Cherohan/Base-ESP32S3-Simple-FOC-Verification-Board/hardware/version2/2.1/SCH_Schematic1_2_2026-10-08.pdf

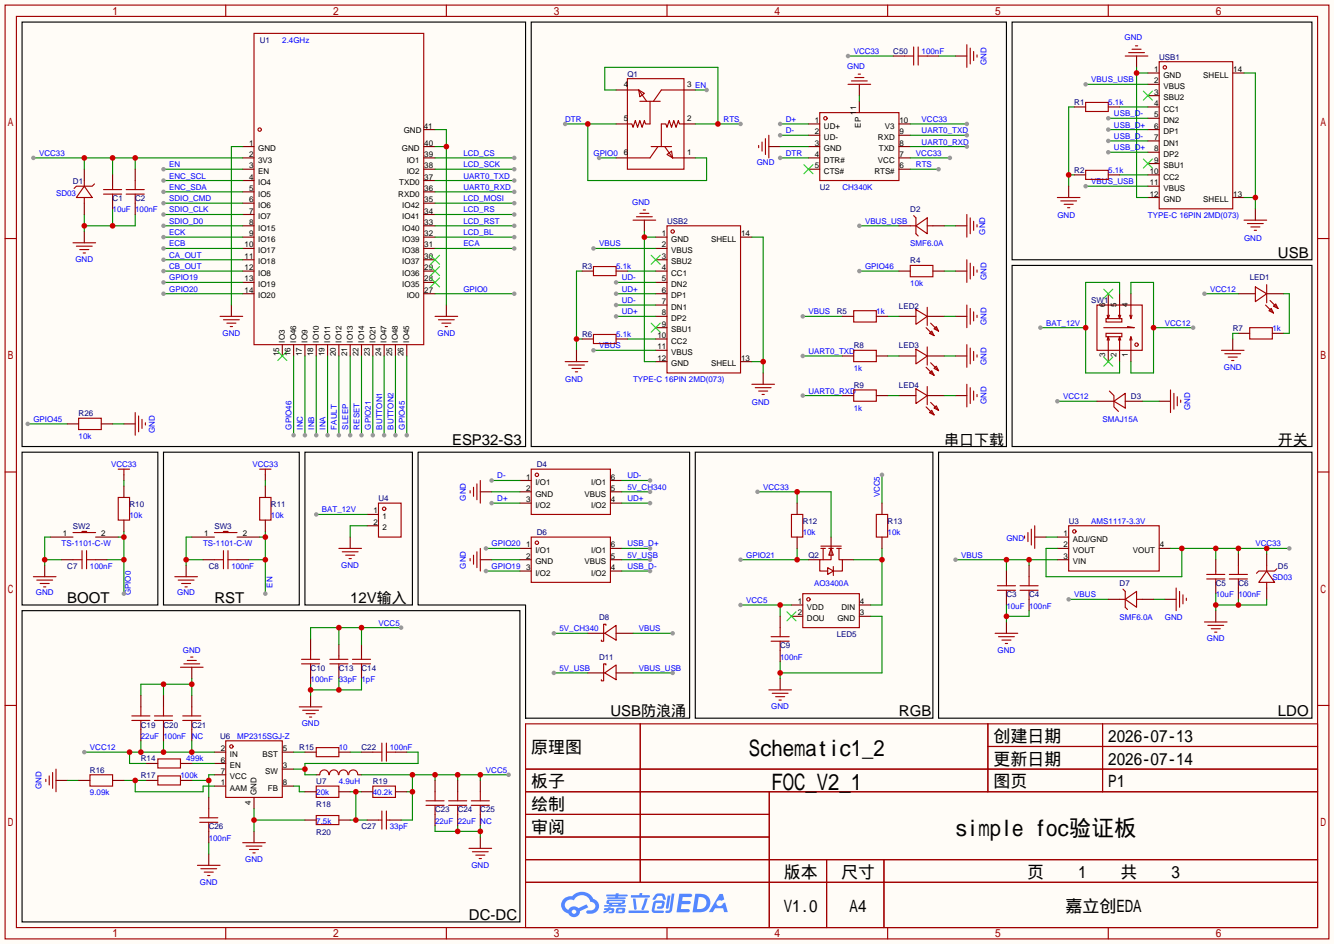
[picture p15: page 1]

原理图 | Schematic1_2 | 创建日期 | 2026-07-13
板子 | FOC_V2_1 | 图页 | P1
绘制 | | simple foc验证板
审阅

更新日期 | 2026-07-14

V1.0 | A4 | 嘉立创EDA

## 电流采样

AS5600

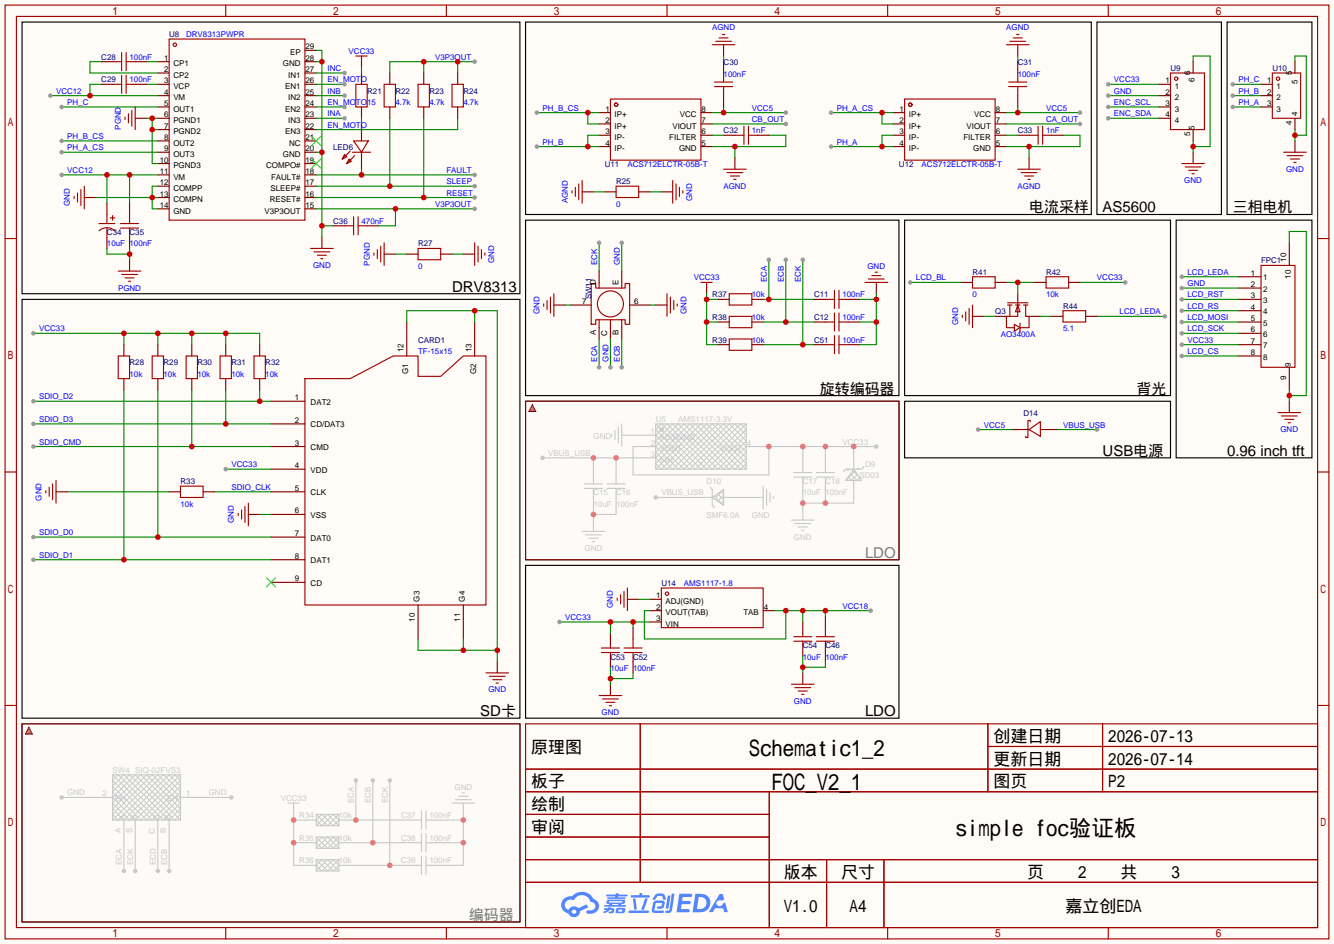
[picture p16: page 2]

原理图 | Schematic1_2 | 创建日期 | 2026-07-13
板子 | FOC_V2_1 | 图页 | P2
绘制 | | simple foc验证板
审阅

更新日期 | 2026-07-14

# 单颗LED正向压降2.1V

## 额定电流20mA

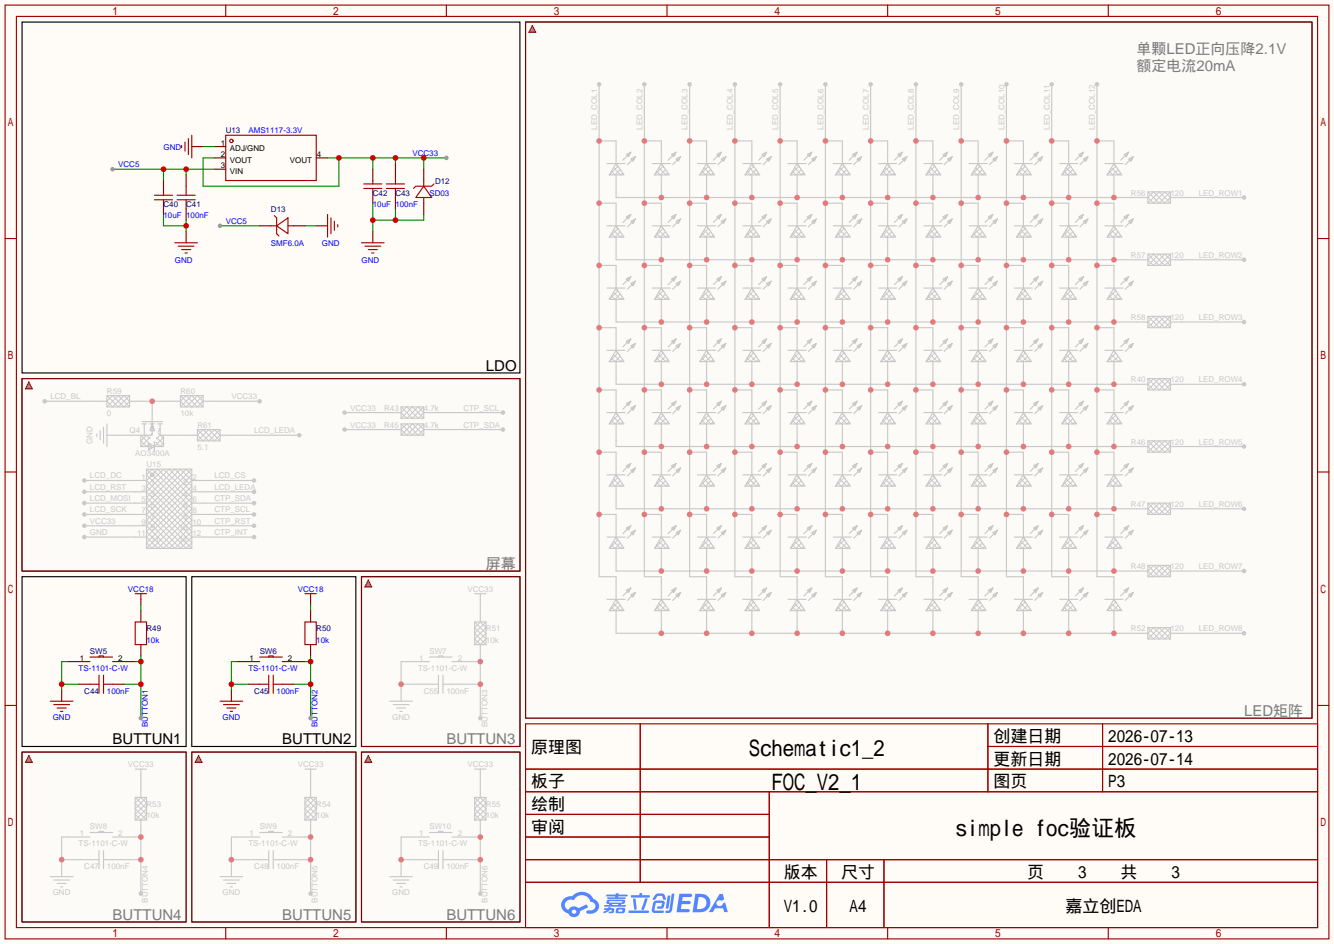
[picture p17: page 3]

原理图 | Schematic1_2 | 创建日期 | 2026-07-13
板子 | FOC_V2_1 | 图页 | P3
绘制 | | simple foc验证板
审阅

更新日期 | 2026-07-14
