Cherohan/Base-ESP32S3-Simple-FOC-Verification-Board/hardware/version2/2.2/SCH_Schematic1_1_2026-10-08.pdf

# Attention

## 当前版本存在以下问题：

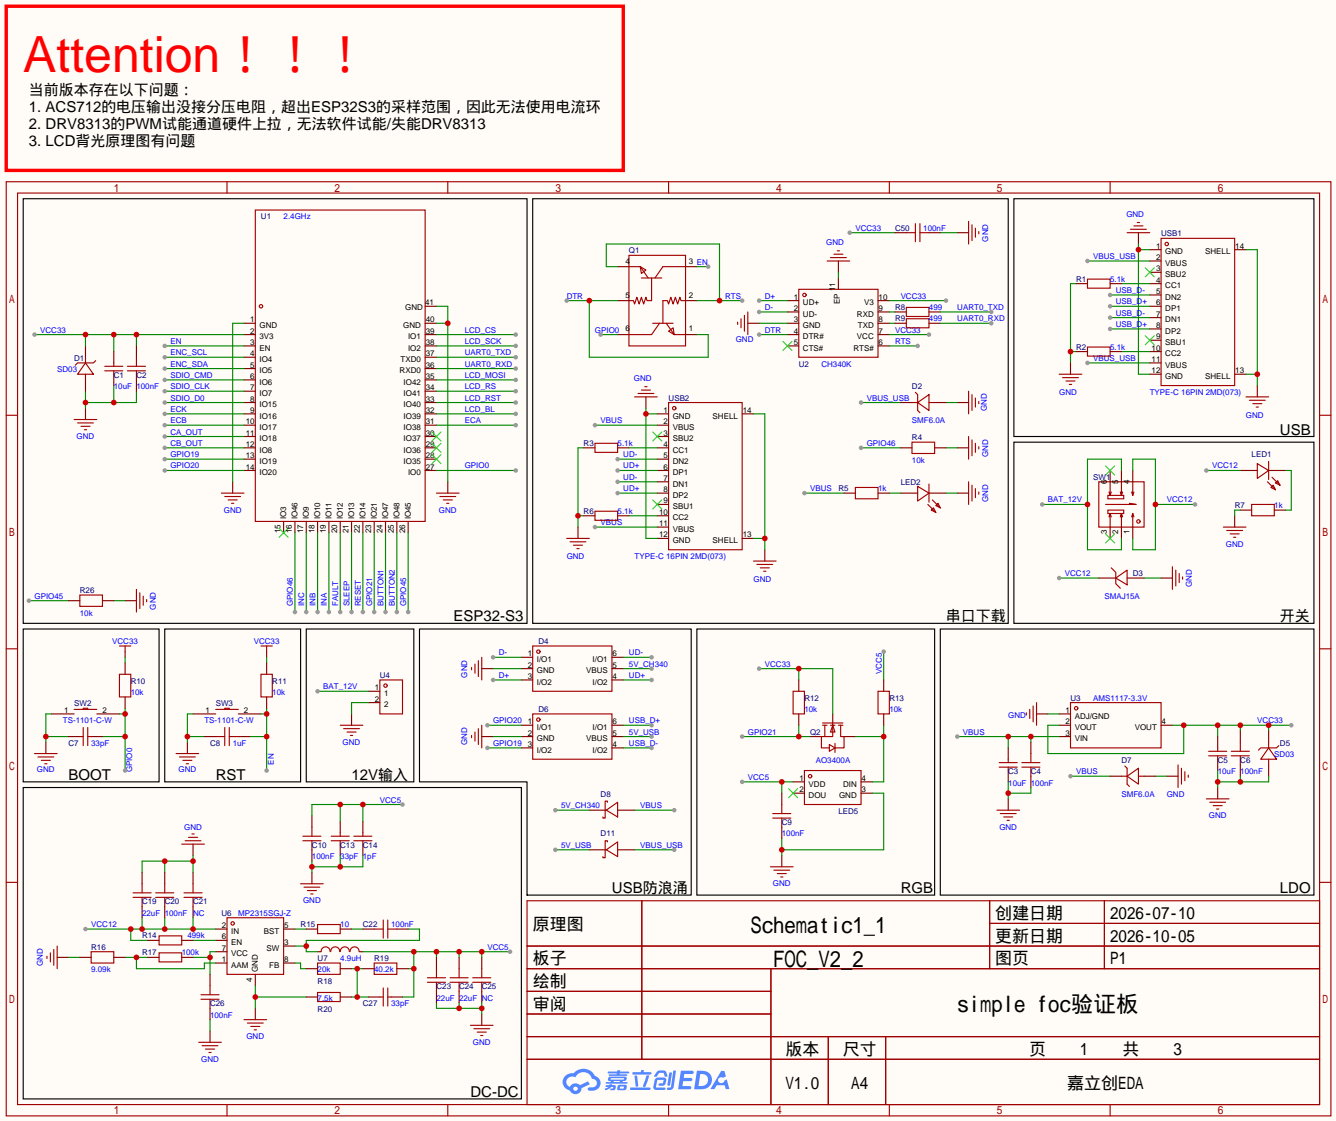
[picture p18: page 1]

原理图 | Schematic1_1 | 创建日期 | 2026-07-10
板子 | FOC_V2_2 | 图页 | P1
绘制 | | simple foc验证板
审阅

更新日期 | 2026-10-05

V1.0 | A4 | 嘉立创EDA

## 电流采样

AS5600

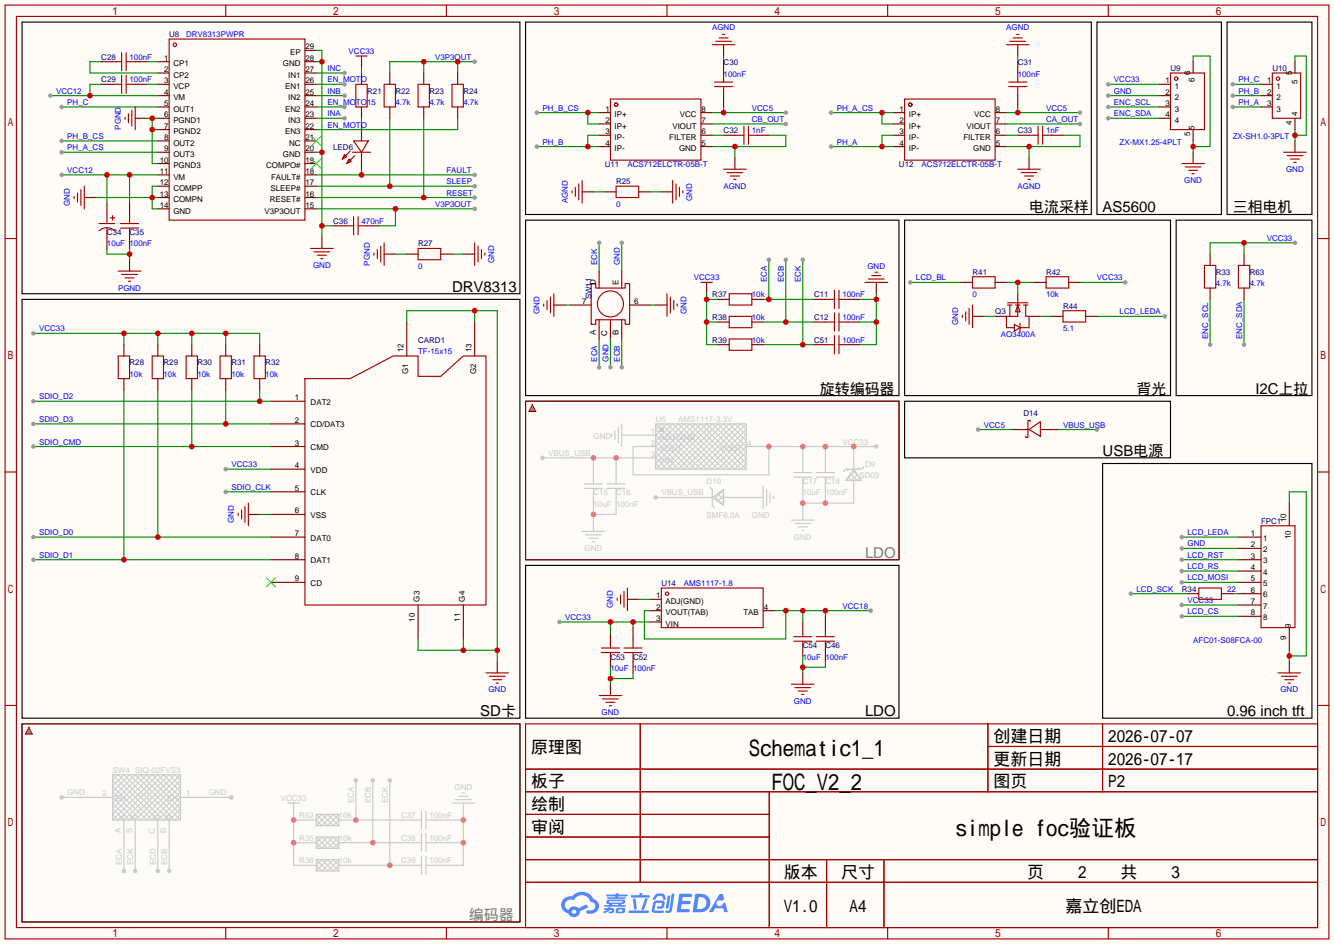
[picture p19: page 2]

原理图 | Schematic1_1 | 创建日期 | 2026-07-07
板子 | FOC_V2_2 | 图页 | P2
绘制 | | simple foc验证板
审阅

更新日期 | 2026-07-17

# 单颗LED正向压降2.1V

## 额定电流20mA

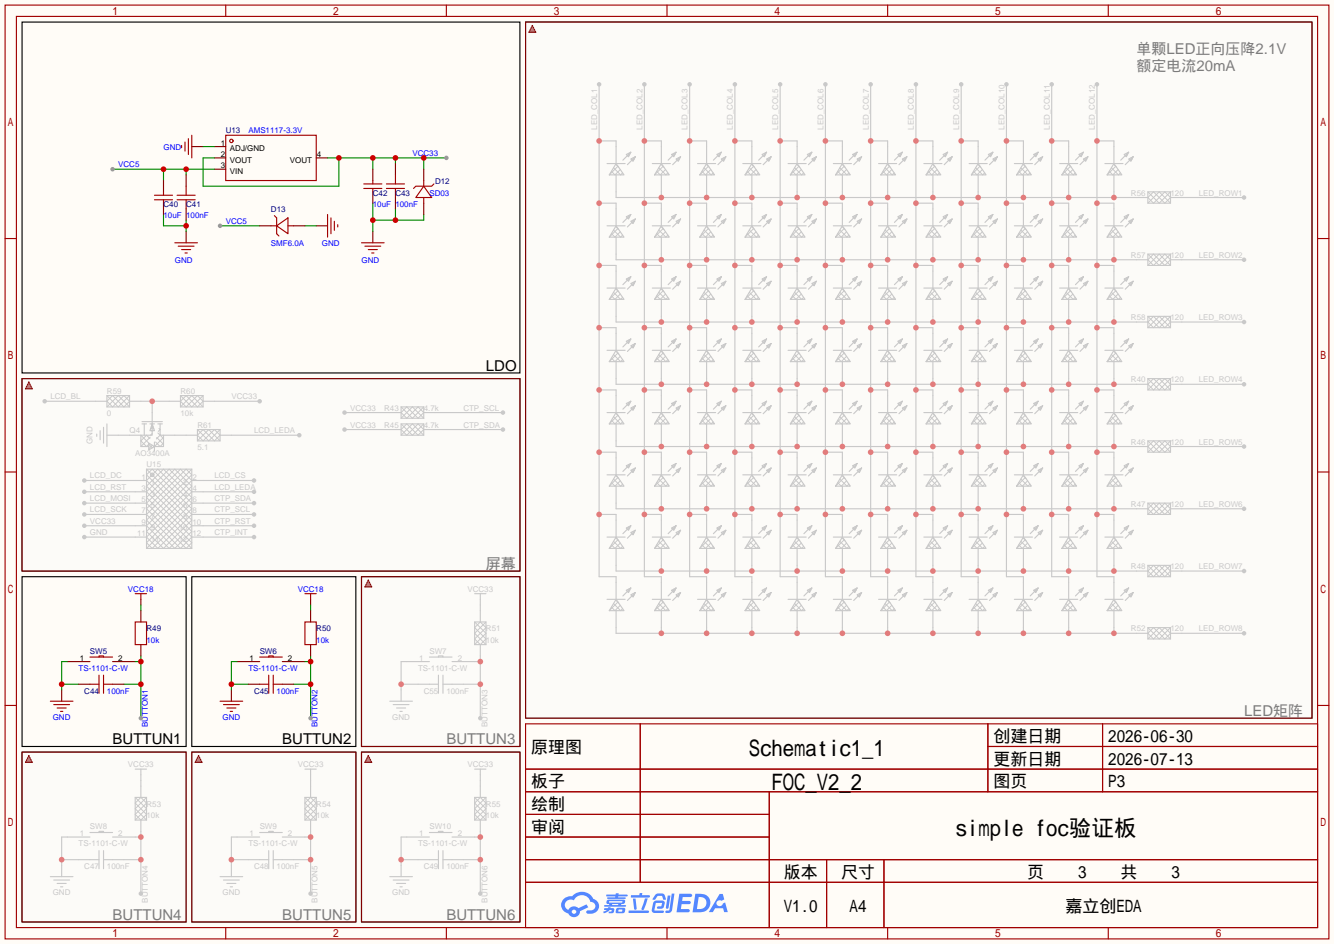
[picture p20: page 3]

原理图 | Schematic1_1 | 创建日期 | 2026-06-30
板子 | FOC_V2_2 | 图页 | P3
绘制 | | simple foc验证板
审阅

更新日期 | 2026-07-13
