Cherohan/Base-ESP32S3-Simple-FOC-Verification-Board/hardware/version2/2.3/SCH_Schematic1_3_2026-10-08.pdf

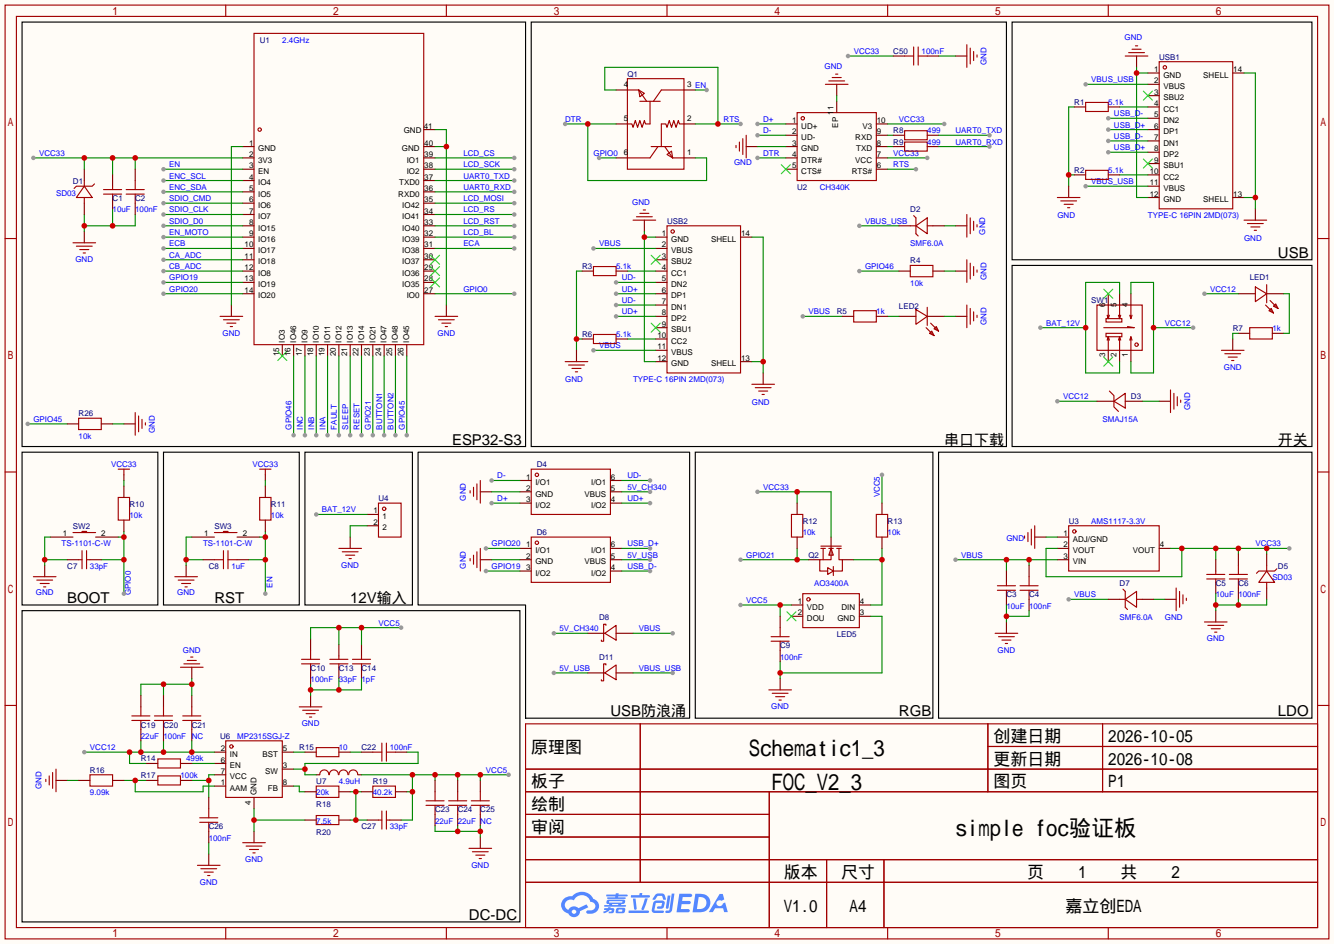
[picture p21: page 1]

原理图 | Schematic1_3 | 创建日期 | 2026-10-05
板子 | FOC_V2_3 | 图页 | P1
绘制 | | simple foc验证板
审阅

更新日期 | 2026-10-08

V1.0 | A4 | 嘉立创EDA

## 电流采样

AS5600 | 三相电机

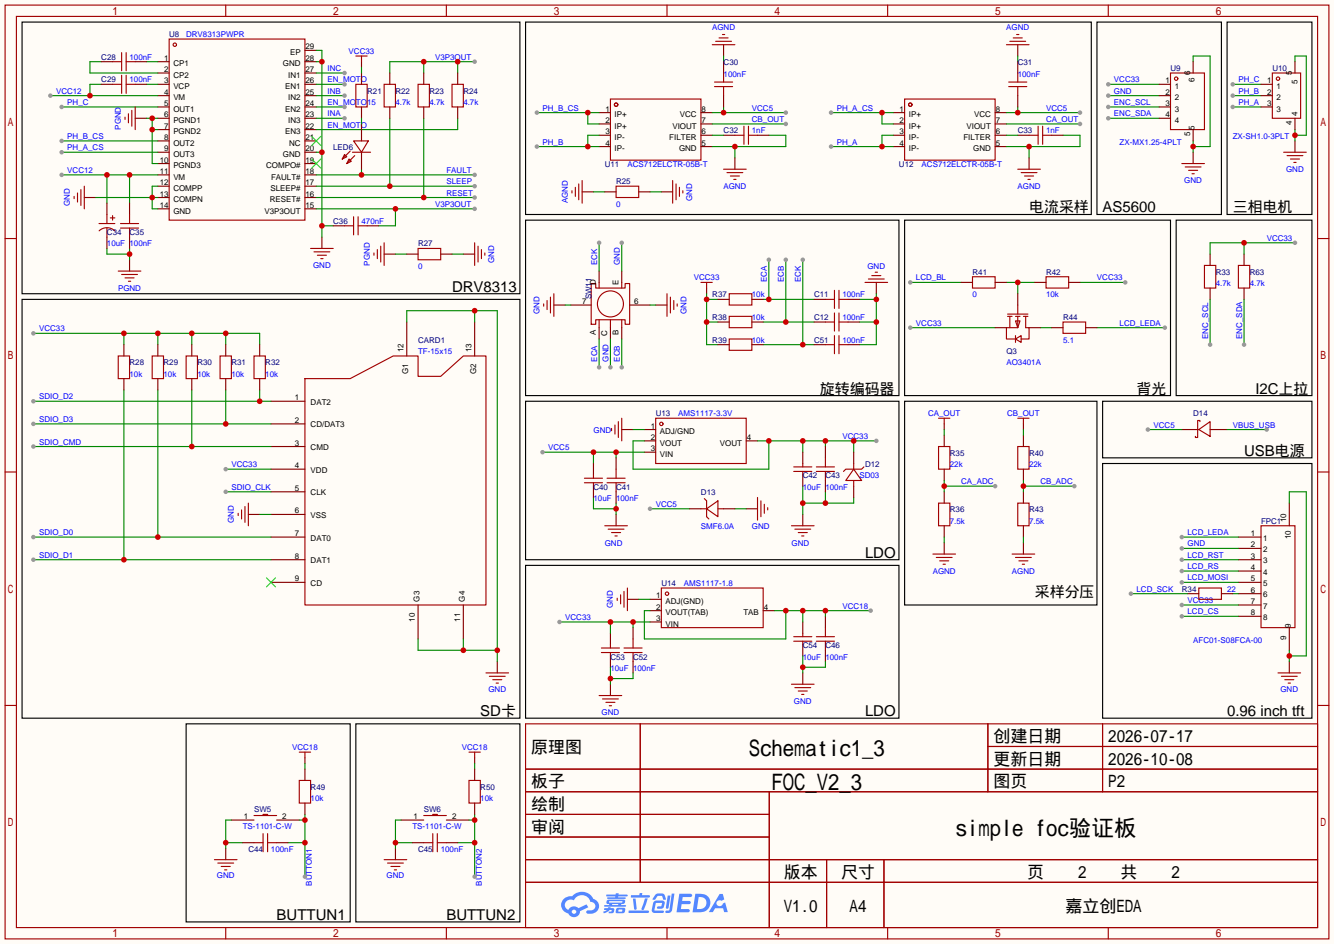
[picture p22: page 2]

原理图 | Schematic1_3 | 创建日期 | 2026-07-17
板子 | FOC_V2_3 | 图页 | P2

更新日期 | 2026-10-08

V1.0 | A4 | 嘉立创EDA
