Cherohan/Base-ESP32S3-Simple-FOC-Verification-Board/hardware/version2/2.1/PCB_FOC_V2_1_2_2026-10-08.pdf

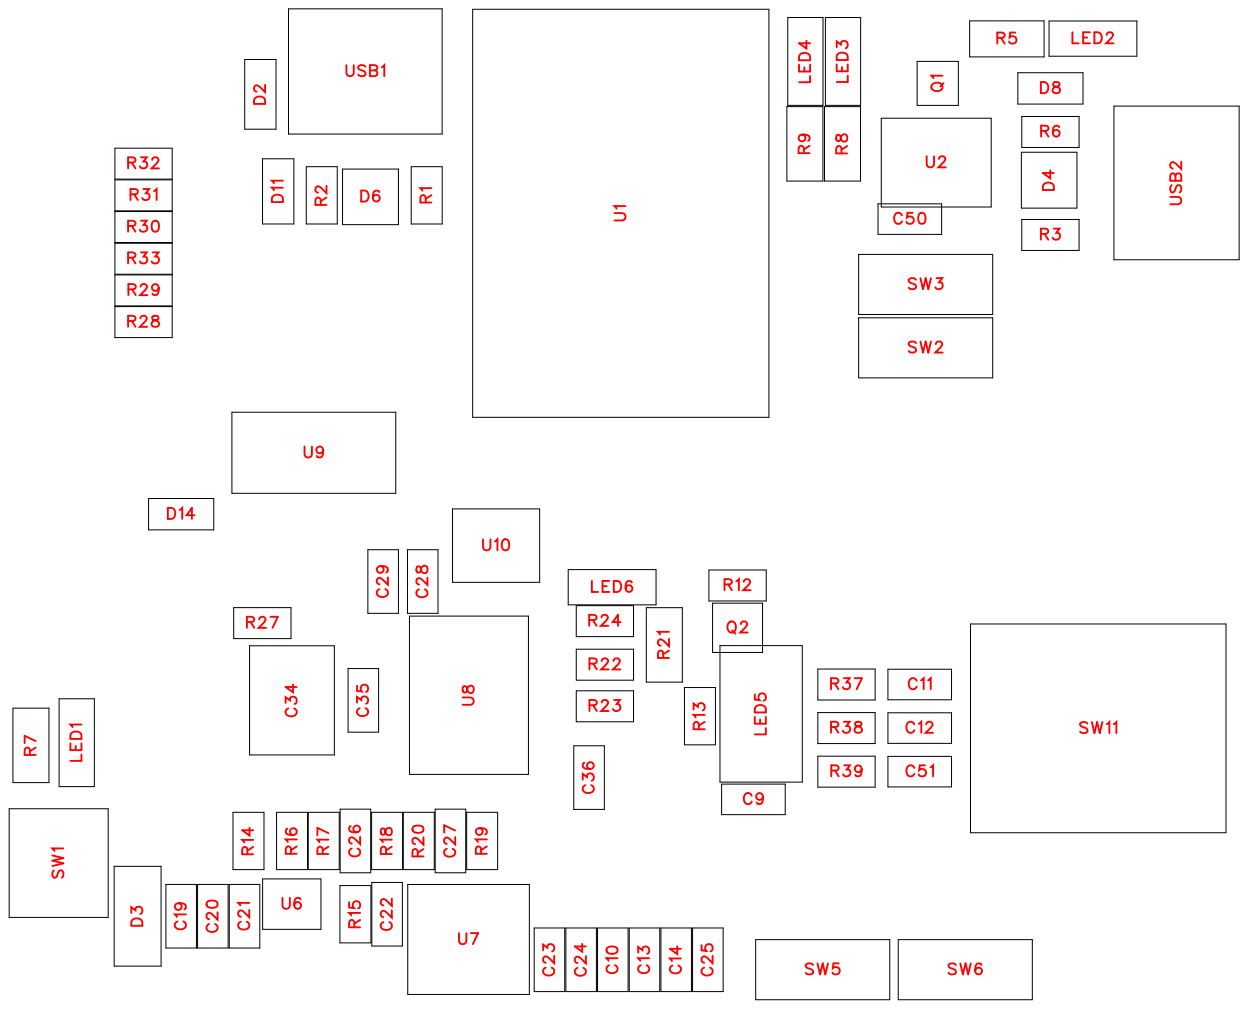
[picture p23: page 1]

R37 | C11
R38 | C12
R39 | C51

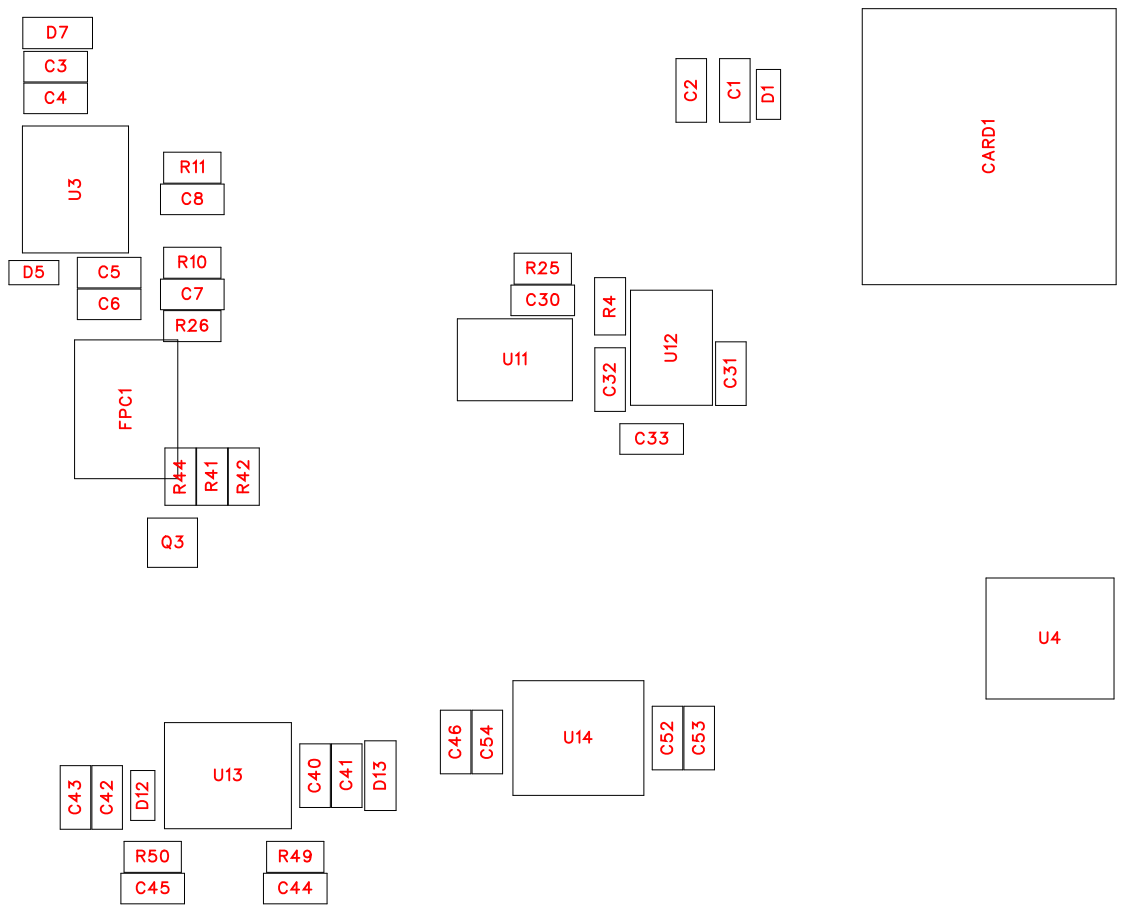
[picture p24: page 2]

R50 | R49
C45 | C44

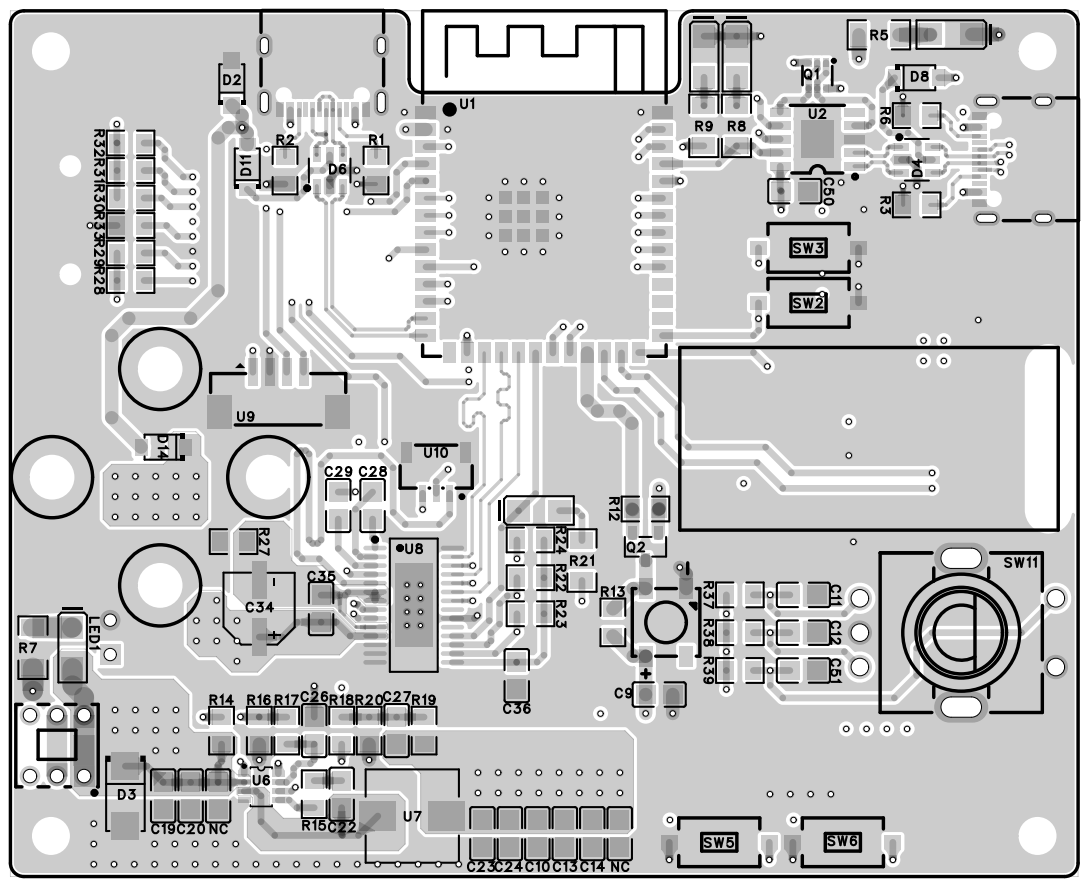
[picture p25: page 3]

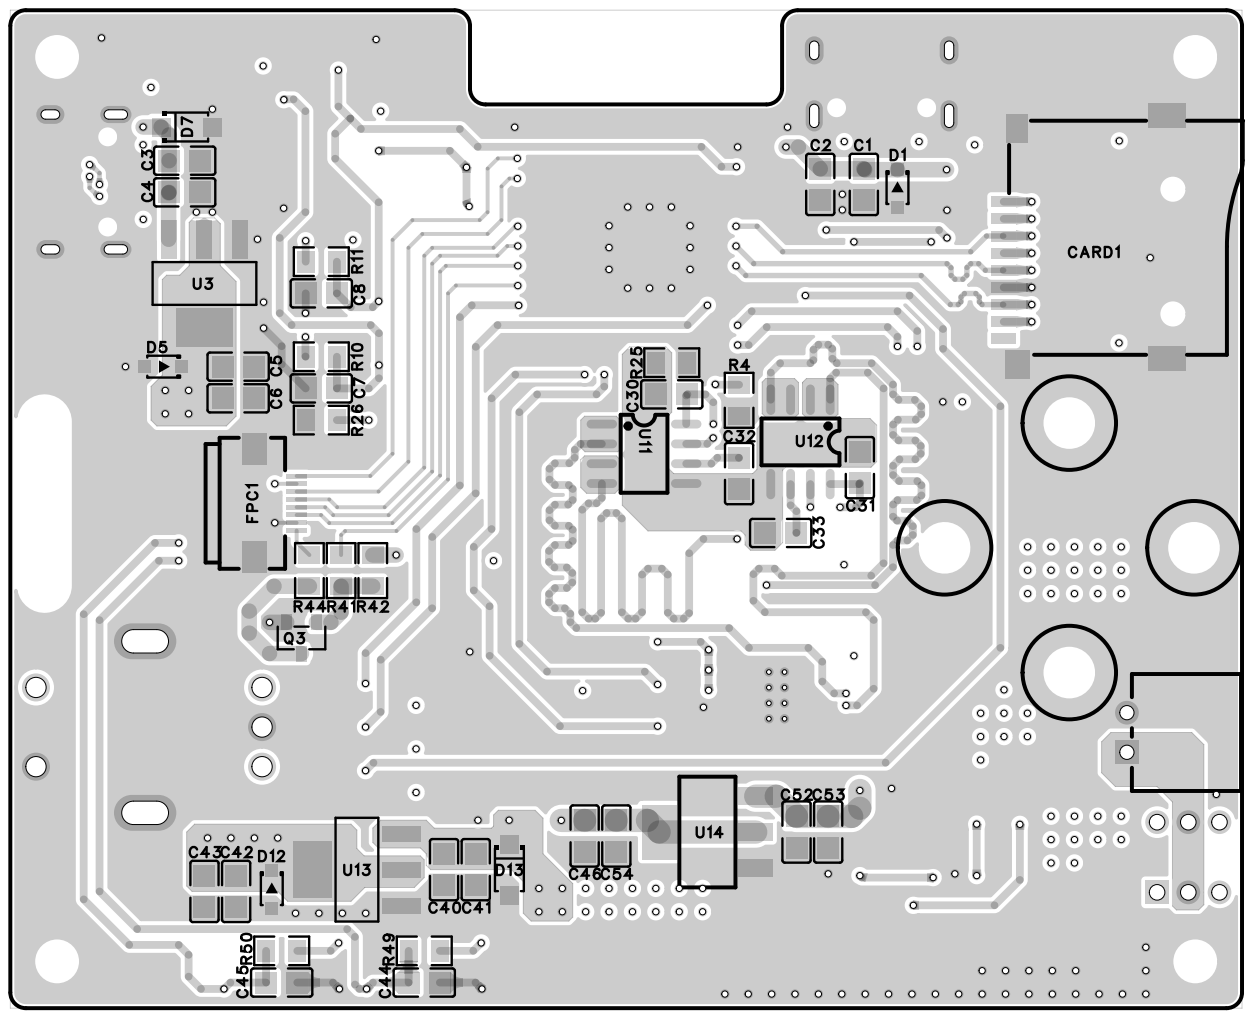
[picture p26: page 4]

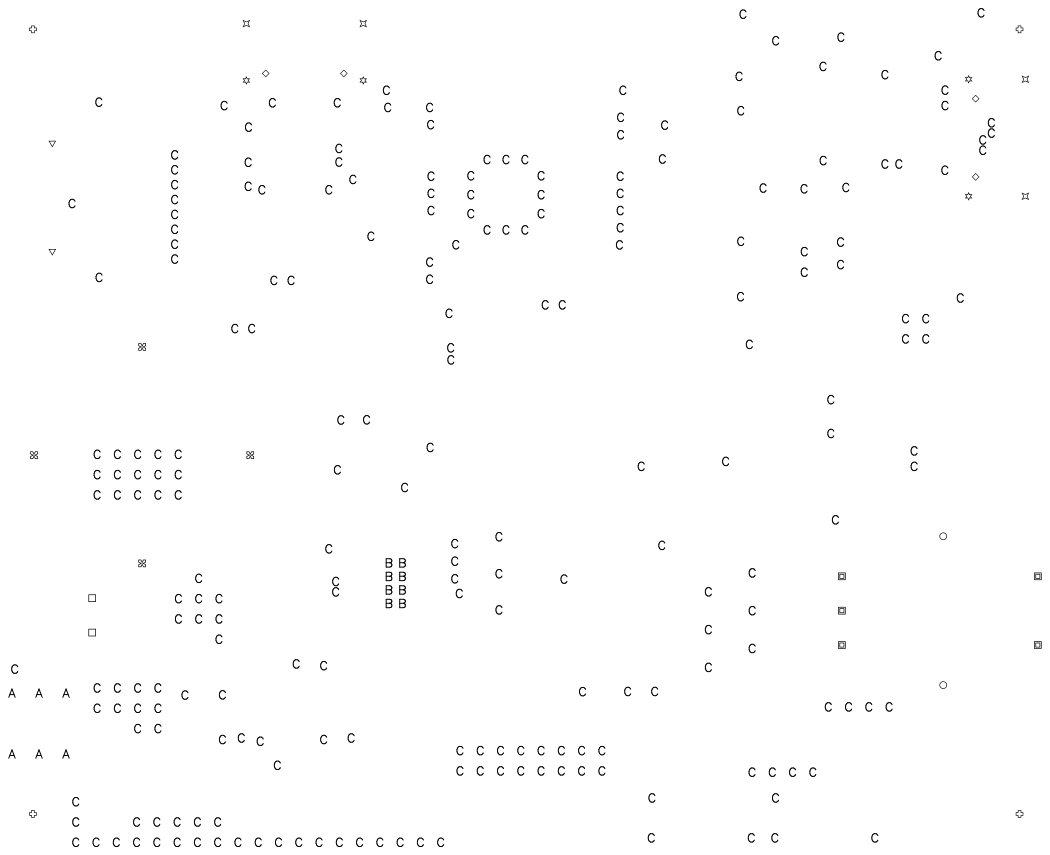
[picture p27: page 5]
