Cherohan/Base-ESP32S3-Simple-FOC-Verification-Board/hardware/version2/2.2/PCB_FOC_V2_2_2026-10-08.pdf

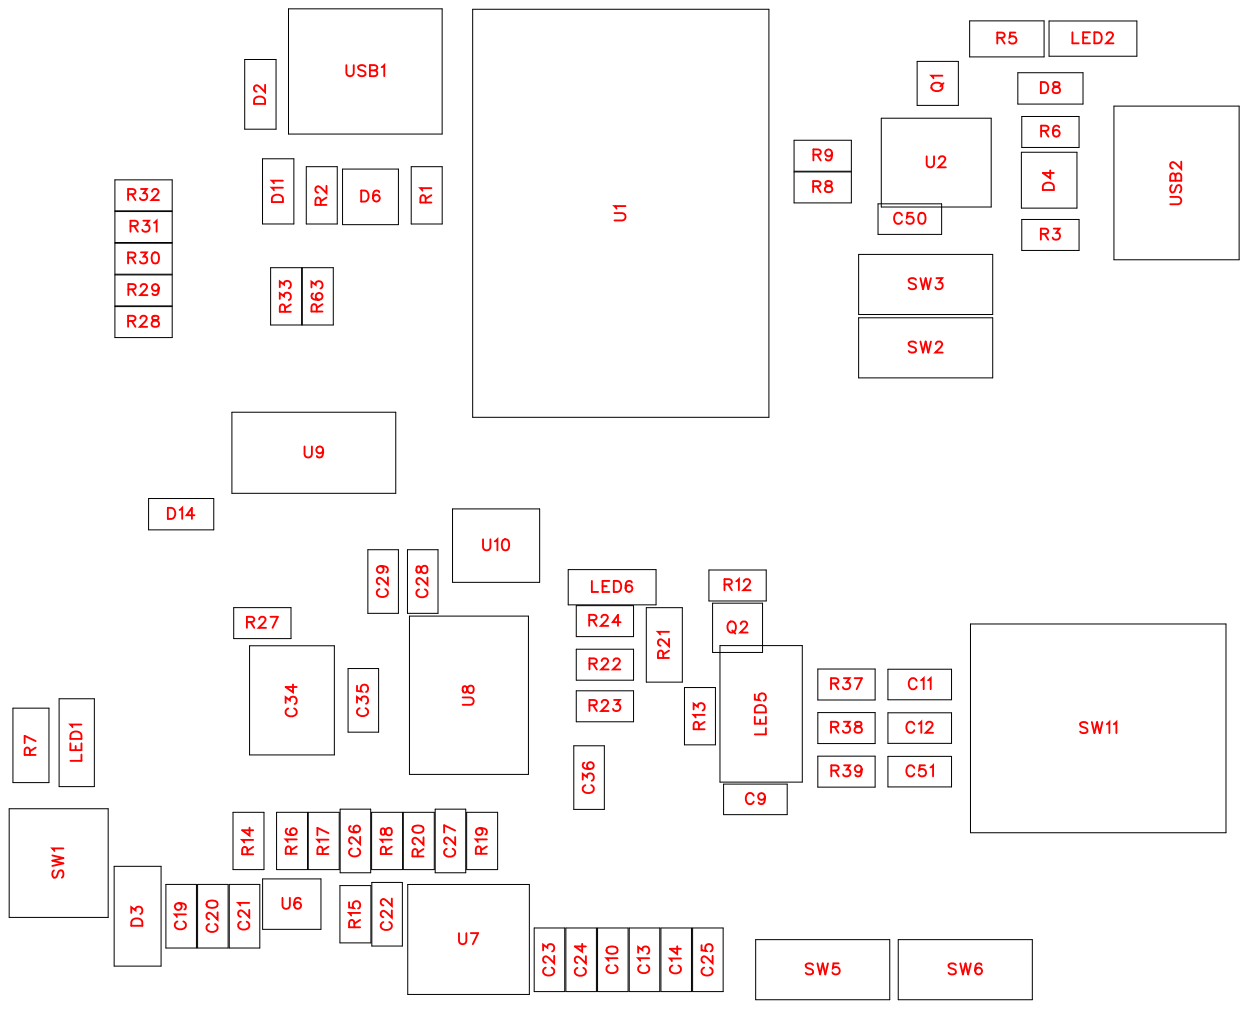
[picture p28: page 1]

R37 | C11
R38 | C12
R39 | C51

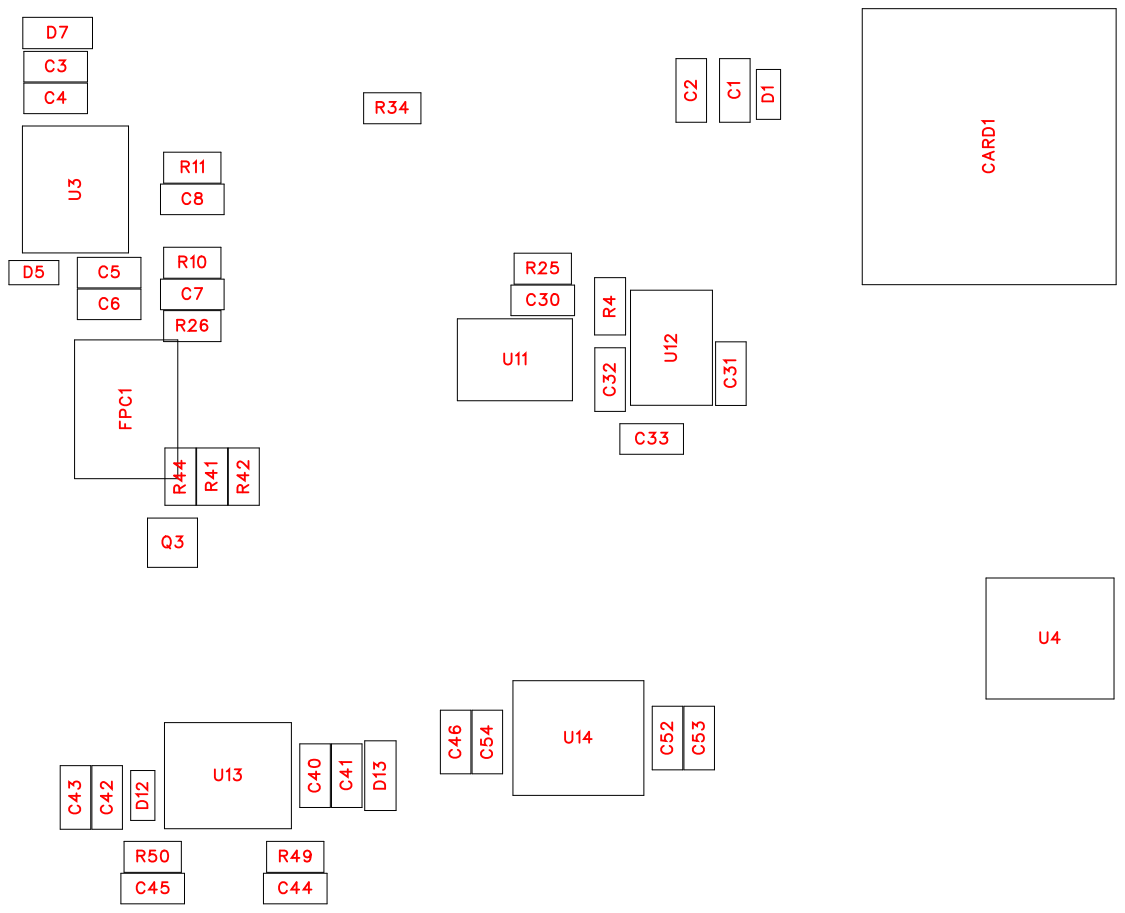
[picture p29: page 2]

R50 | R49
C45 | C44

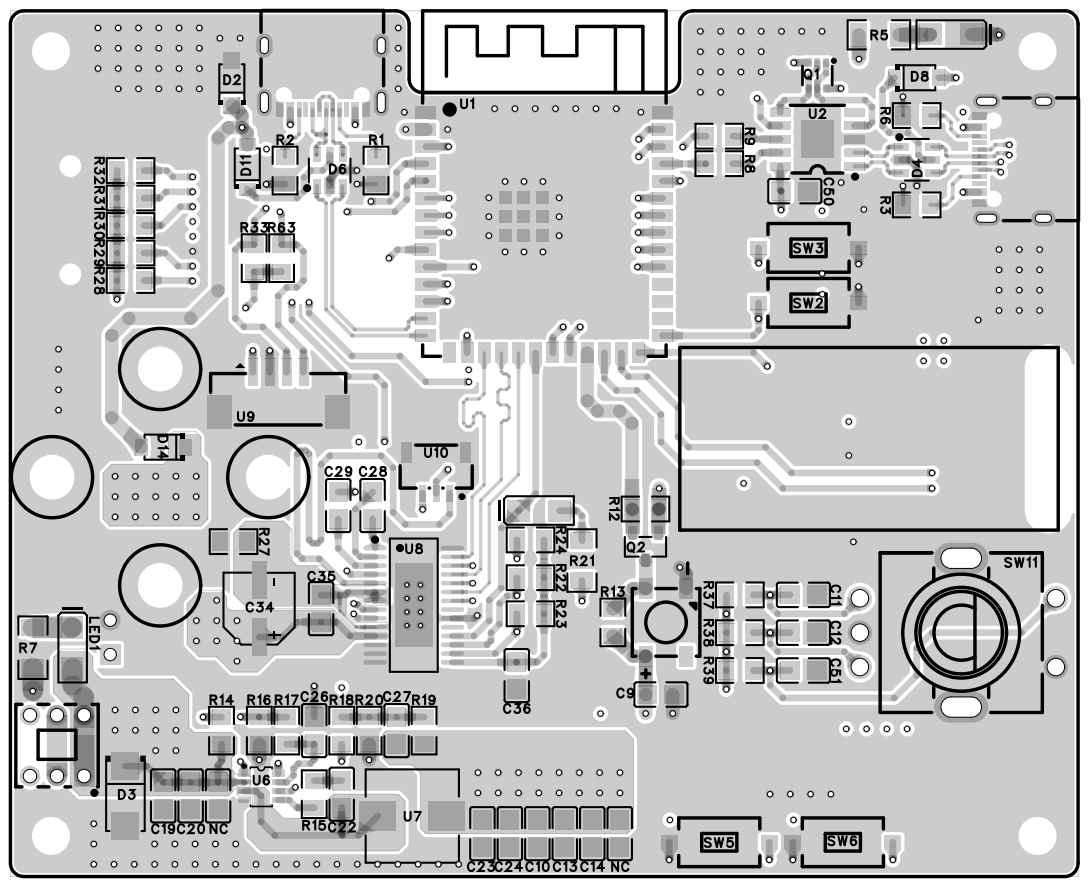
[picture p30: page 3]

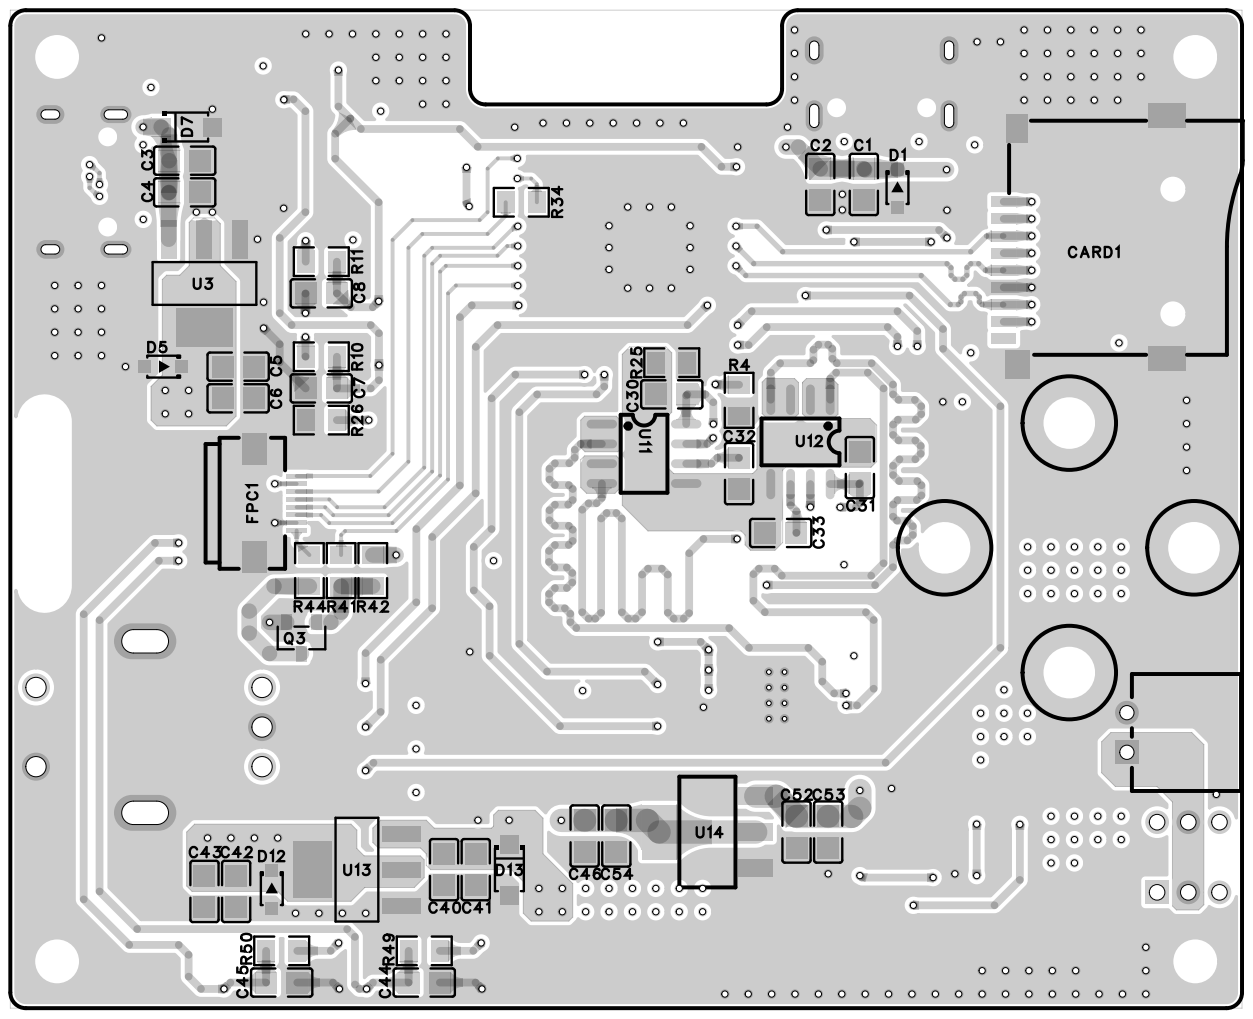
[picture p31: page 4]

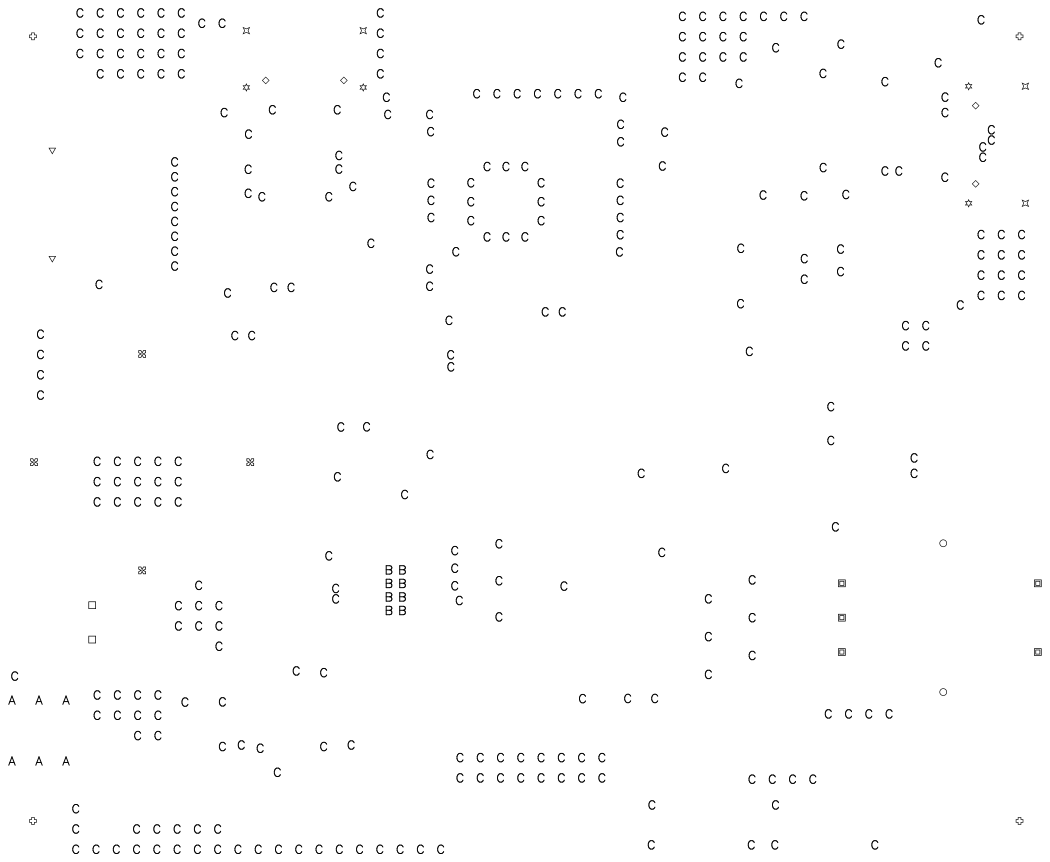
[picture p32: page 5]
