Cherohan/Base-ESP32S3-Simple-FOC-Verification-Board/hardware/version2/2.3/PCB_FOC_V2_3_2026-10-08.pdf

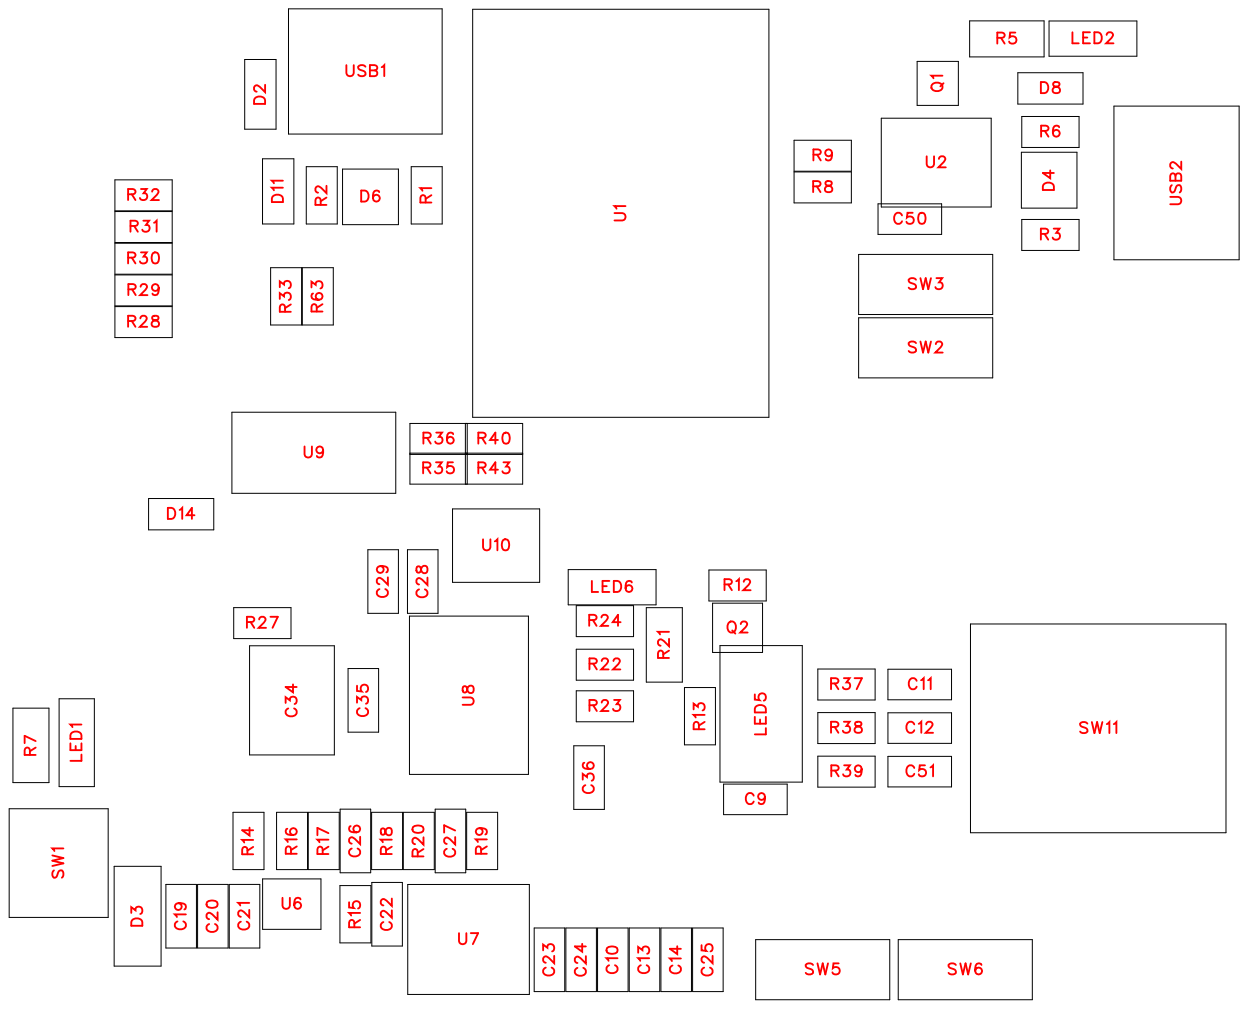
[picture p33: page 1]

R37 | C11
R38 | C12
R39 | C51

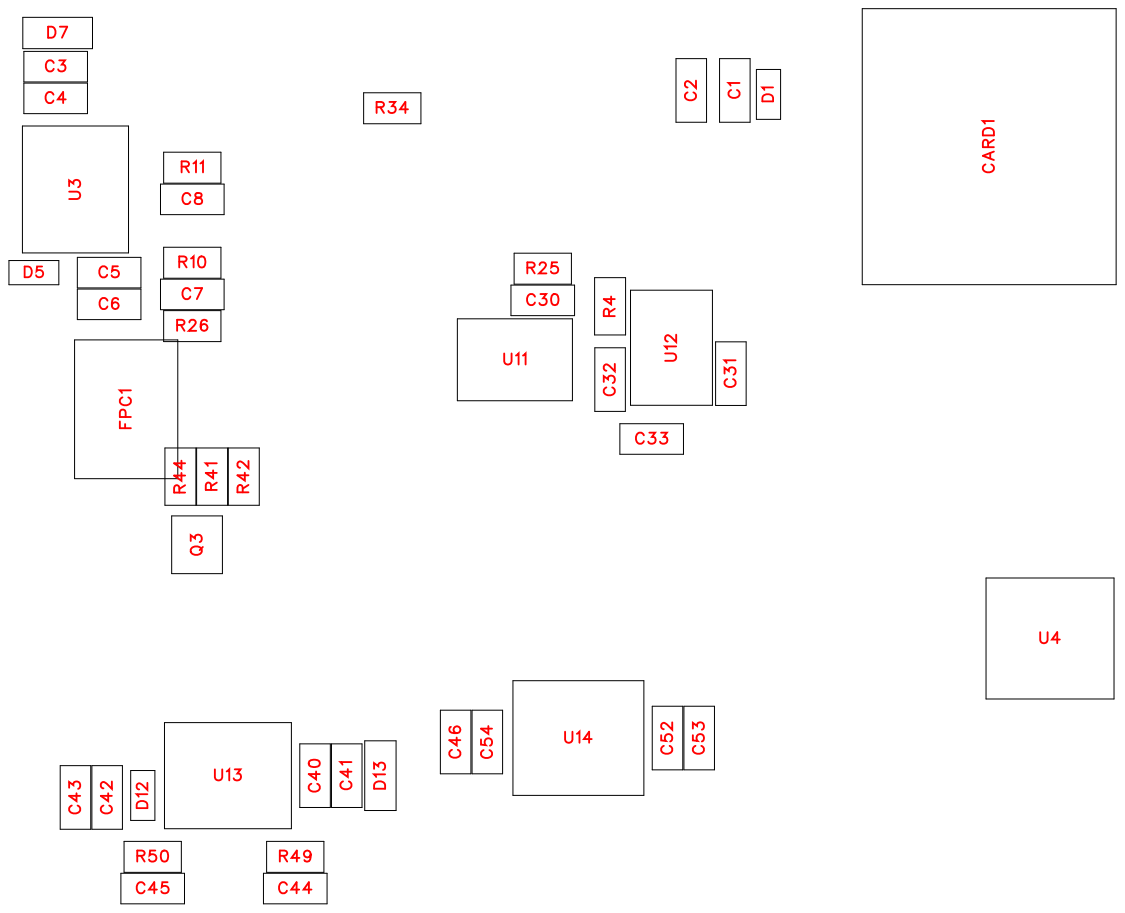
[picture p34: page 2]

R50 | R49
C45 | C44

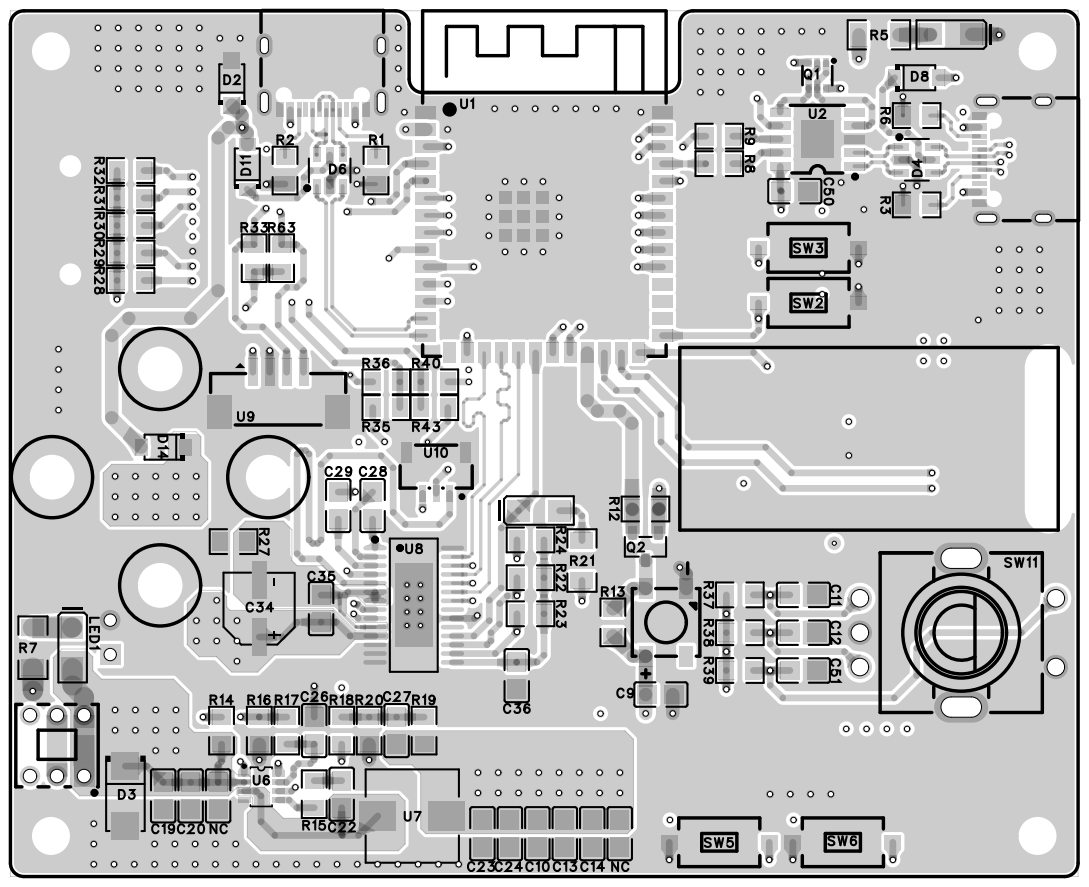
[picture p35: page 3]

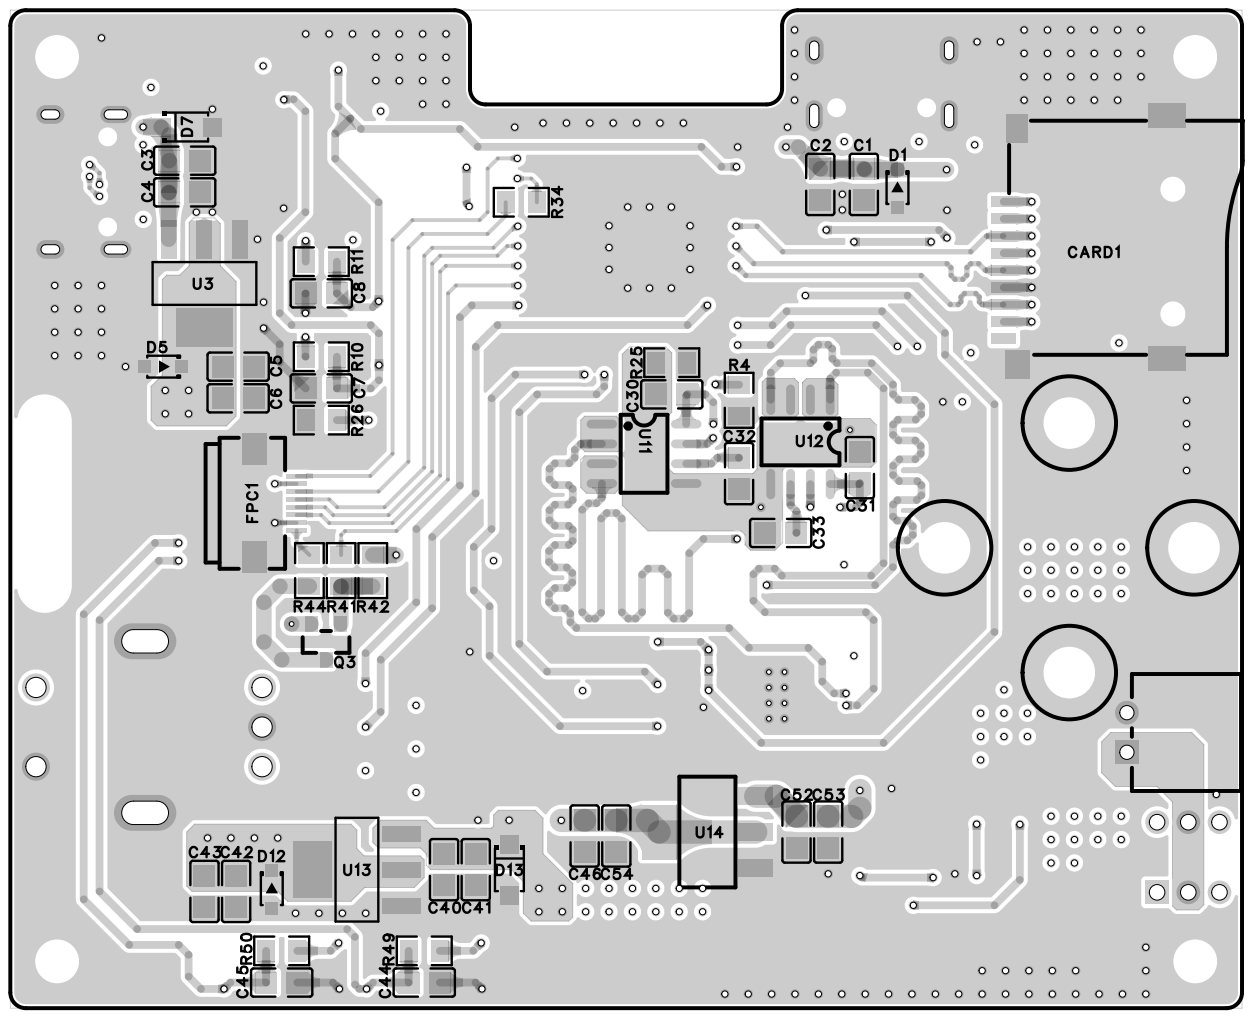
[picture p36: page 4]

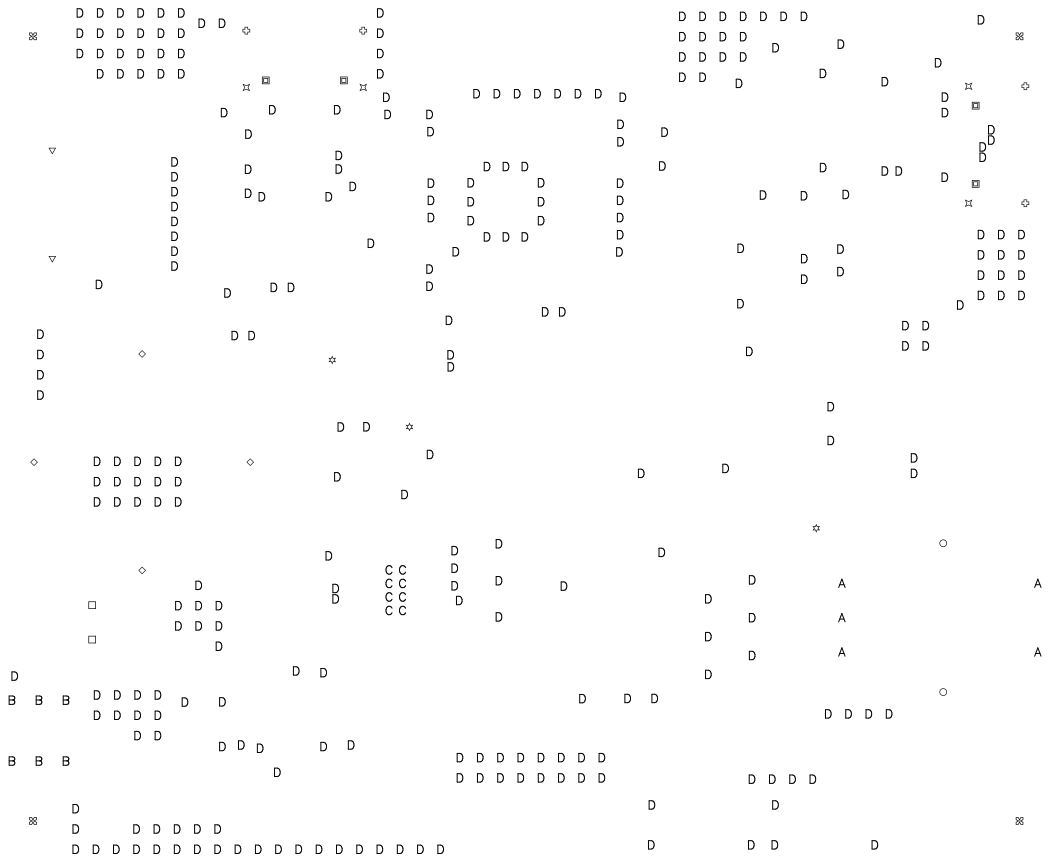
[picture p37: page 5]
